btor/TU58-DECtape-II-Emulator/images/tu58-ard-02.png

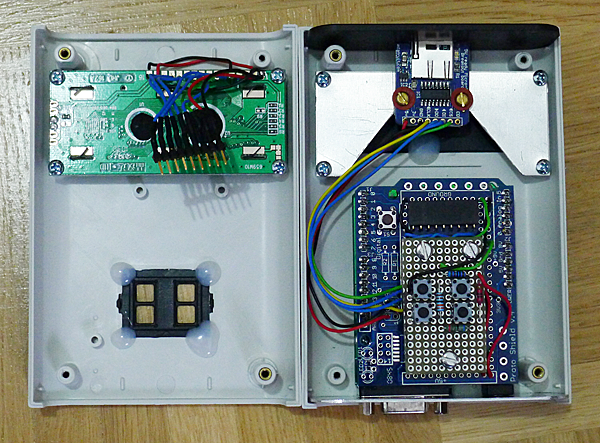
images/tu58-ard-02.png
