btor/TU58-DECtape-II-Emulator/images/tu58-arduino-and-lsi11.png

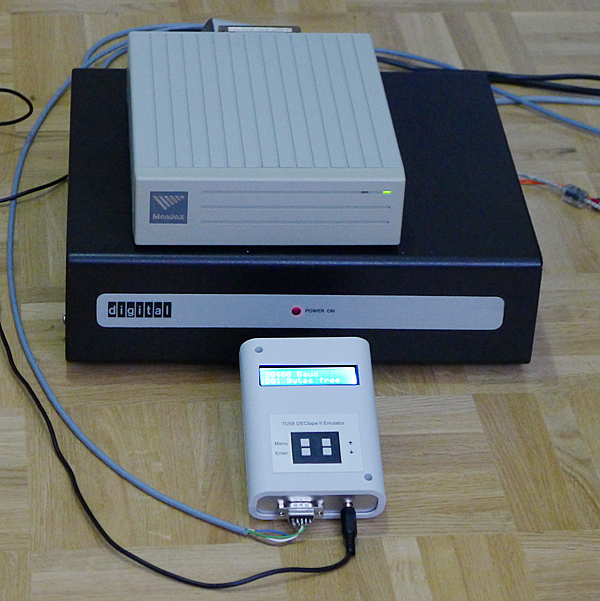
images/tu58-arduino-and-lsi11.png
