btor/TU58-DECtape-II-Emulator/images/circuit_diagram.png

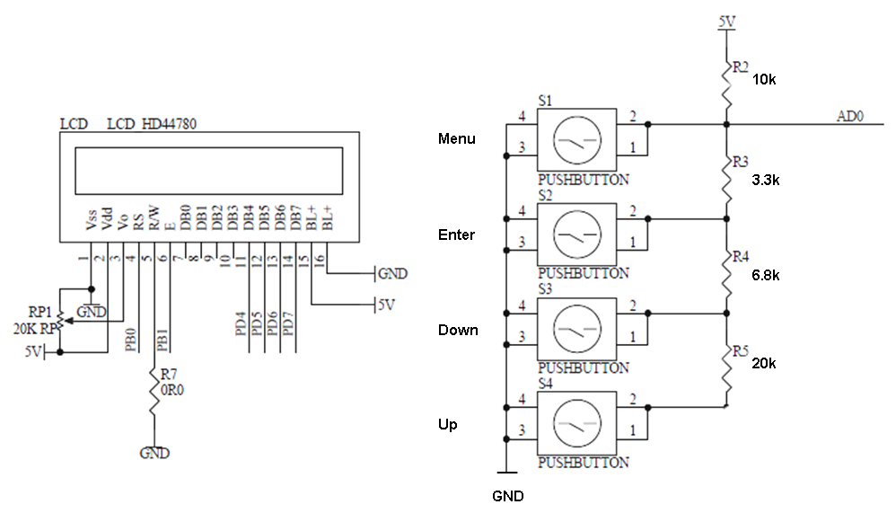
images/circuit_diagram.png
