btor/TU58-DECtape-II-Emulator/images/Leonardo.png

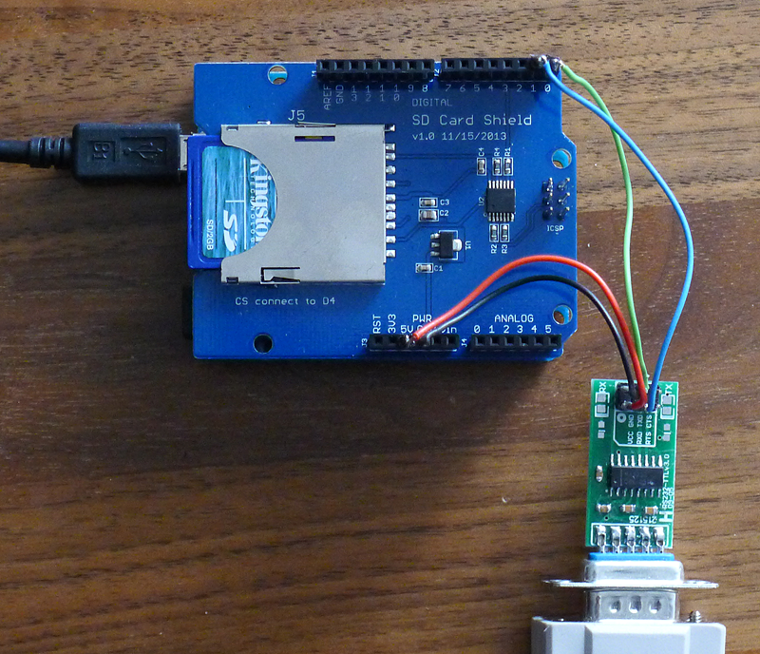
images/Leonardo.png
