btor/TU58-DECtape-II-Emulator/images/putty_activity.png

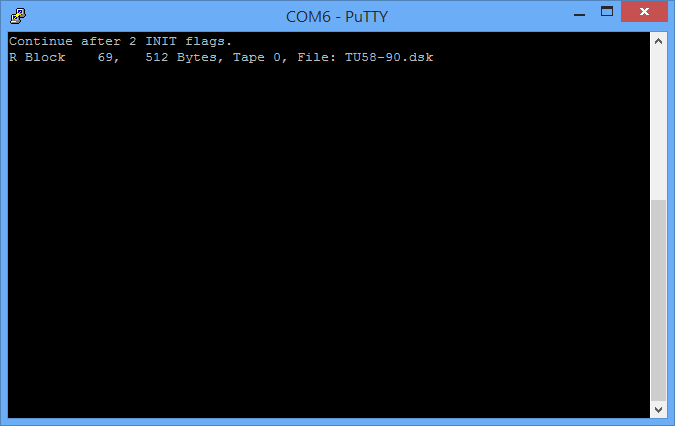
images/putty_activity.png
