btor/TU58-DECtape-II-Emulator/images/putty_menu.png

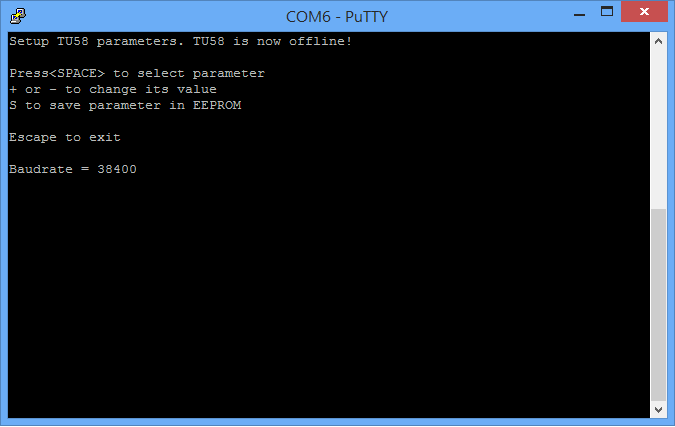
images/putty_menu.png
