btor/TU58-DECtape-II-Emulator/images/tu58-arduino.png

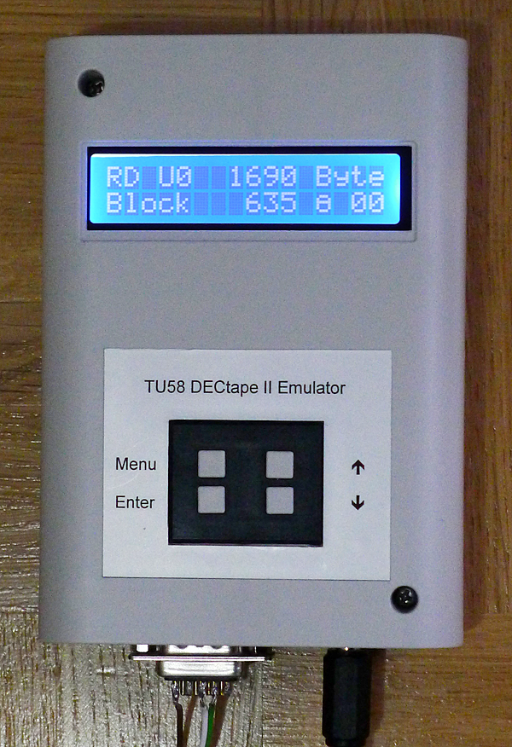
images/tu58-arduino.png
