btor/TU58-DECtape-II-Emulator/images/tu58-dev.png

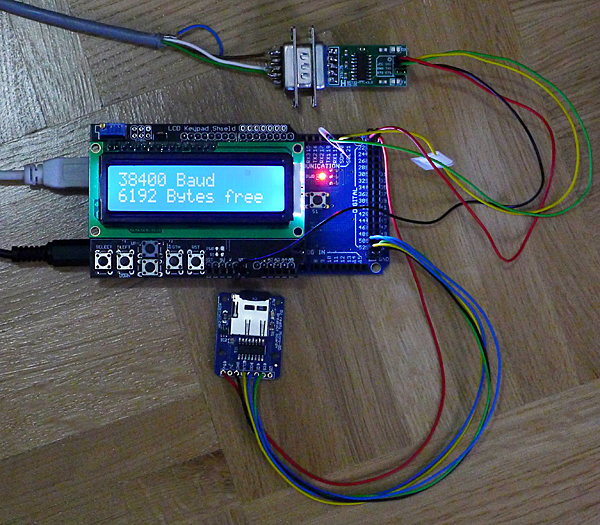
images/tu58-dev.png
