btor/TU58-DECtape-II-Emulator/images/tu58-display.png

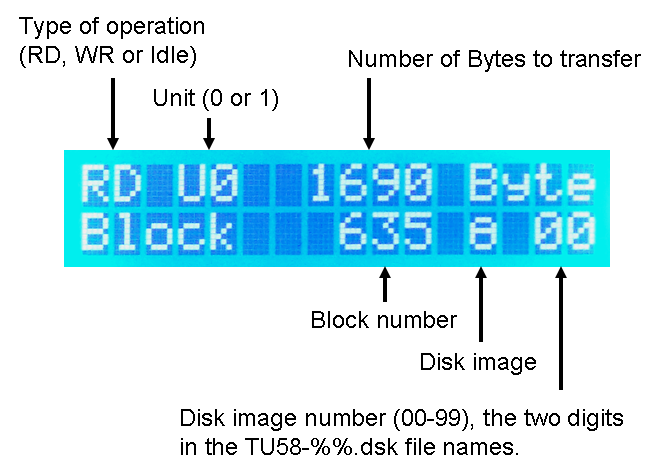
images/tu58-display.png
