btor/TU58-DECtape-II-Emulator/images/tu58.jpg

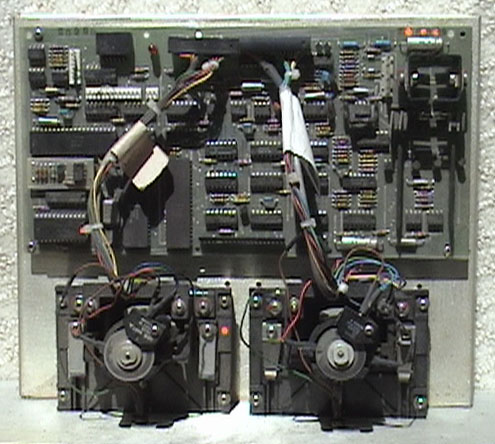
images/tu58.jpg
