btor/TU58-DECtape-II-Emulator/images/Tu58-Leonardo_Circuit_diagram.pdf

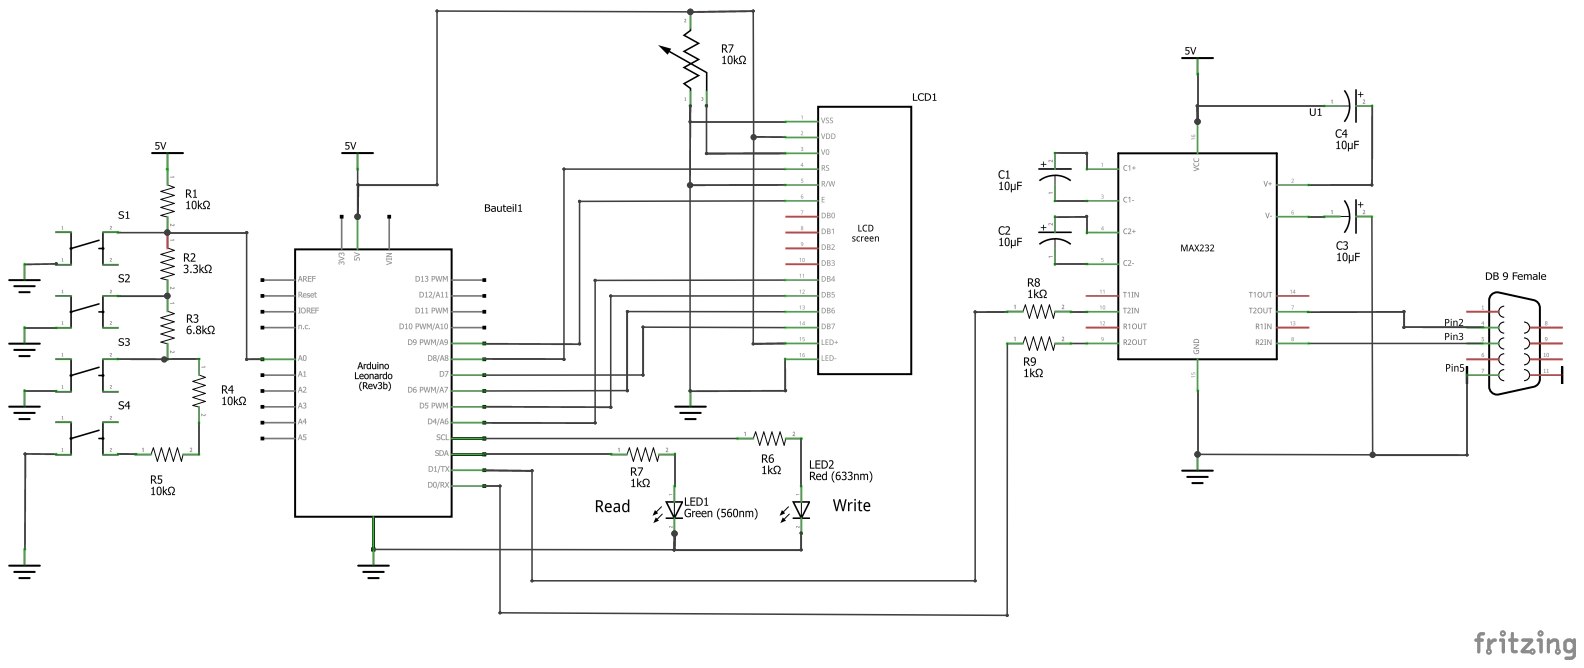
[picture p12: page 1]
