btor/TU58-DECtape-II-Emulator/images/Tu58-Mega_Circuit_diagram.pdf

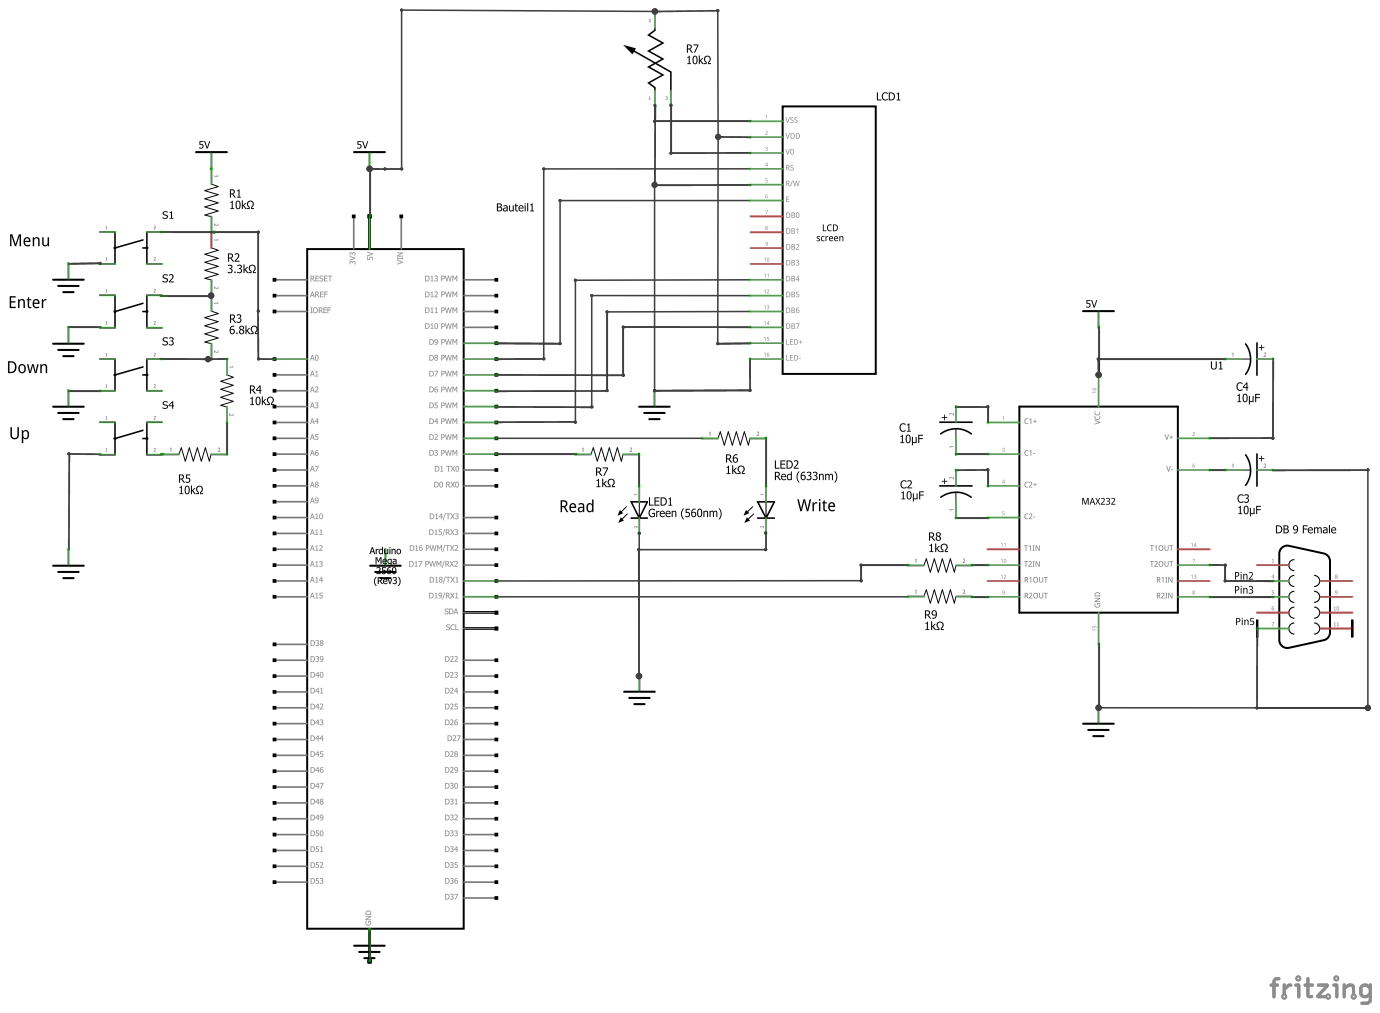
[picture p13: page 1]
