btor/TU58-DECtape-II-Emulator/(notices)

Notices in the files:
tu58.ino:
License as published by the Free Software Foundation version 2 of the
License (http://www.gnu.org/licenses/gpl.txt).
